3komma3volt/ssx32/README.md

# ssx32
Open source servo controller
using a PIC18F46K20

software by Michael Bradley http://www.mculabs.com/projects/ssx32.html

hardware by berndp using Eagle 7.0 Freeware
