3komma3volt/ssx32/Hardware/ssx32.brd

## EAGLE design Hardware/ssx32.brd (2016-06-15)

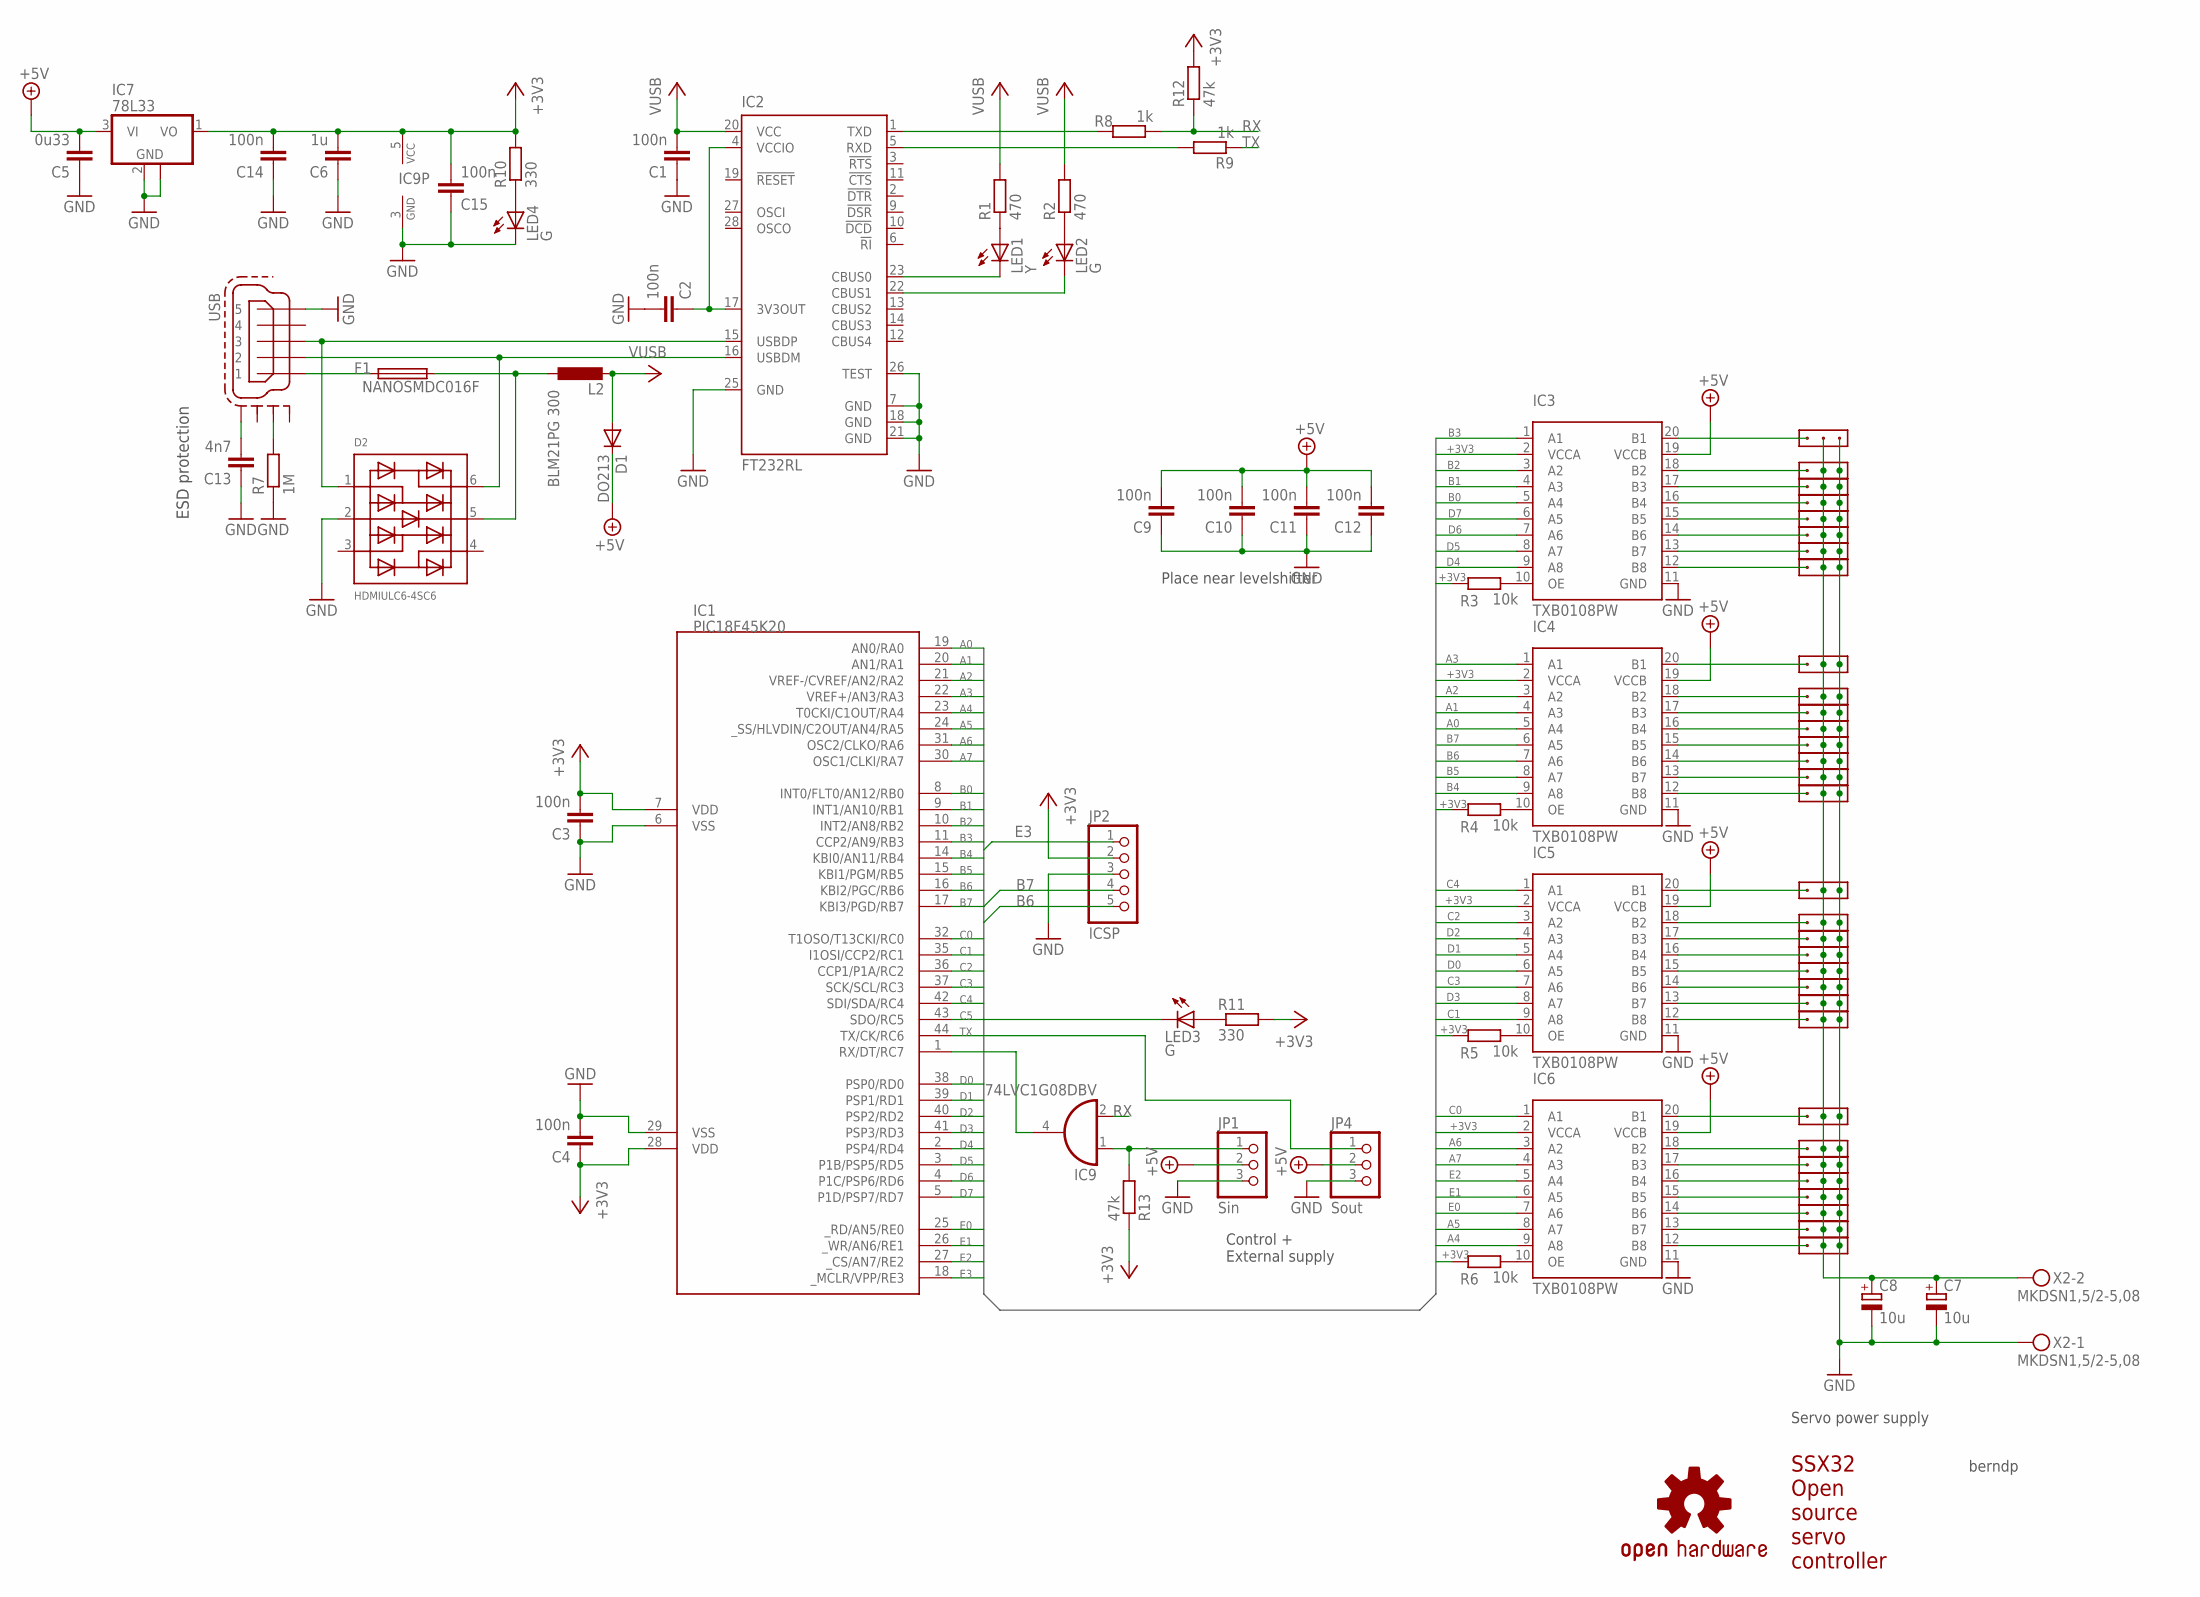
[picture p1: schematic ssx32.sch]

Parts:
C1, C2, C3, C4, C9, C10, C11, C12, C14, C15: 100n; C0603
C5: 0u33; C0805
C6: 1u; C0603
C7, C8: 10u; 153CLV-0505
C13: 4n7; C0603
D1: DO213; MINIMELF
D2: HDMIULC6-4SC6; SOT23-5
F1: NANOSMDC016F
IC1: PIC18F45K20; PIC18FXX20_TQFP44
IC2: FT232RL; SSOP28
IC3, IC4, IC5, IC6: TXB0108PW; PW_R-PDSO-G20
IC7: 78L33; SOT89
IC9: 74LVC1G08DBV; SOT23-5
JP1: Sin; 1X03
JP2: ICSP; 1X05
JP4: Sout; 1X03
L2: BLM21PG 300; R0805
LED1: Y; CHIPLED_0603
LED2, LED3, LED4: G; CHIPLED_0603
R1, R2: 470; R0603
R3, R4, R5, R6: 10k; R0603
R7: 1M; R0603
R8, R9: 1k; R0603
R10, R11: 330; R0603
R12, R13: 47k; R0603
U$2: OSHW-LOGOM; OSHW-LOGO-M
X1: 8; 1X3
X2: MKDSN1,5/2-5,08
X3: 17; 1X3
X4: 7; 1X3
X5: 6; 1X3
X6: 5; 1X3
X7: 4; 1X3
X8: 3; 1X3
X9: 2; 1X3
X10: 1; 1X3
X11: 19; 1X3
X12: 16; 1X3
X13: 15; 1X3
X14: 14; 1X3
X15: 13; 1X3
X16: 12; 1X3
X17: 11; 1X3
X18: 10; 1X3
X19: 9; 1X3
X20: 20; 1X3
X21: 21; 1X3
X22: 22; 1X3
X23: 23; 1X3
X24: 24; 1X3
X25: 25; 1X3
X26: 26; 1X3
X27: 27; 1X3
X28: 28; 1X3
X29: 29; 1X3
X30: 30; 1X3
X31: 31; 1X3
X32: 32; 1X3
X34: 18; 1X3
X35: USB; 32005-301

Connections:
+3V3: C3.2, C4.1, C6.2, C14.2, C15.2, IC1.7 (VDD), IC1.28 (VDD), IC3.2 (VCCA), IC4.2 (VCCA), IC5.2 (VCCA), IC6.2 (VCCA), IC7.1 (VO), IC9.5 (VCC), JP2.2, R3.1, R4.1, R5.1, R6.1, R10.2, R11.2, R12.2, R13.1
+5V: C1.2, D1.A, IC2.20 (VCC), L2.2, R1.2, R2.2
+UB: C5.2, C9.2, C10.2, C11.2, C12.2, D1.C, IC3.19 (VCCB), IC4.19 (VCCB), IC5.19 (VCCB), IC6.19 (VCCB), IC7.3 (VI), JP1.2, JP4.2
A0: IC1.19 (AN0/RA0), IC4.5 (A4)
A1: IC1.20 (AN1/RA1), IC4.4 (A3)
A2: IC1.21 (VREF-/CVREF/AN2/RA2), IC4.3 (A2)
A3: IC1.22 (VREF+/AN3/RA3), IC4.1 (A1)
A4: IC1.23 (T0CKI/C1OUT/RA4), IC6.9 (A8)
A5: IC1.24 (_SS/HLVDIN/C2OUT/AN4/RA5), IC6.8 (A7)
A6: IC1.31 (OSC2/CLKO/RA6), IC6.3 (A2)
A7: IC1.30 (OSC1/CLKI/RA7), IC6.4 (A3)
B0: IC1.8 (INT0/FLT0/AN12/RB0), IC3.5 (A4)
B1: IC1.9 (INT1/AN10/RB1), IC3.4 (A3)
B2: IC1.10 (INT2/AN8/RB2), IC3.3 (A2)
B3: IC1.11 (CCP2/AN9/RB3), IC3.1 (A1)
B4: IC1.14 (KBI0/AN11/RB4), IC4.9 (A8)
B5: IC1.15 (KBI1/PGM/RB5), IC4.8 (A7)
B6: IC1.16 (KBI2/PGC/RB6), IC4.7 (A6), JP2.5
B7: IC1.17 (KBI3/PGD/RB7), IC4.6 (A5), JP2.4
C0: IC1.32 (T1OSO/T13CKI/RC0), IC6.1 (A1)
C1: IC1.35 (I1OSI/CCP2/RC1), IC5.9 (A8)
C2: IC1.36 (CCP1/P1A/RC2), IC5.8 (A7)
C3: IC1.37 (SCK/SCL/RC3), IC5.7 (A6)
C4: IC1.42 (SDI/SDA/RC4), IC5.1 (A1)
C5: IC1.43 (SDO/RC5), LED3.C
D0: IC1.38 (PSP0/RD0), IC5.6 (A5)
D1: IC1.39 (PSP1/RD1), IC5.5 (A4)
D2: IC1.40 (PSP2/RD2), IC5.4 (A3)
D3: IC1.41 (PSP3/RD3), IC5.3 (A2)
D4: IC1.2 (PSP4/RD4), IC3.9 (A8)
D5: IC1.3 (P1B/PSP5/RD5), IC3.8 (A7)
D6: IC1.4 (P1C/PSP6/RD6), IC3.7 (A6)
D7: IC1.5 (P1D/PSP7/RD7), IC3.6 (A5)
E0: IC1.25 (_RD/AN5/RE0), IC6.7 (A6)
E1: IC1.26 (_WR/AN6/RE1), IC6.6 (A5)
E2: IC1.27 (_CS/AN7/RE2), IC6.5 (A4)
E3: IC1.18 (_MCLR/VPP/RE3), JP2.1
GND: C1.1, C2.2, C3.1, C4.2, C5.1, C6.1, C7.-, C8.-, C9.1, C10.1, C11.1, C12.1, C13.1, C14.1, C15.1, D2.2, IC1.6 (VSS), IC1.29 (VSS), IC2.7 (GND), IC2.18 (GND), IC2.21 (GND), IC2.25 (GND), IC2.26 (TEST), IC3.11 (GND), IC4.11 (GND), IC5.11 (GND), IC6.11 (GND), IC7.2 (GND), IC7.2@1 (GND), IC9.3 (GND), JP1.3, JP2.3, JP4.3, LED4.C, R7.1, X1.P$3, X2.1, X3.P$3, X4.P$3, X5.P$3, X6.P$3, X7.P$3, X8.P$3, X9.P$3, X10.P$3, X11.P$3, X12.P$3, X13.P$3, X14.P$3, X15.P$3, X16.P$3, X17.P$3, X18.P$3, X19.P$3, X20.P$3, X21.P$3, X22.P$3, X23.P$3, X24.P$3, X25.P$3, X26.P$3, X27.P$3, X28.P$3, X29.P$3, X30.P$3, X31.P$3, X32.P$3, X34.P$3, X35.5
unnamed: D2.6, IC2.16 (USBDM), X35.2
unnamed: F1.1, X35.1
unnamed: IC2.23 (CBUS0), LED1.C
unnamed: IC2.22 (CBUS1), LED2.C
unnamed: LED1.A, R1.1
unnamed: LED2.A, R2.1
unnamed: IC3.20 (B1), X1.P$1
unnamed: IC3.10 (OE), R3.2
unnamed: IC4.10 (OE), R4.2
unnamed: IC5.10 (OE), R5.2
unnamed: IC6.10 (OE), R6.2
unnamed: IC4.18 (B2), X13.P$1
unnamed: IC3.18 (B2), X4.P$1
unnamed: IC3.17 (B3), X5.P$1
unnamed: IC3.16 (B4), X6.P$1
unnamed: IC3.15 (B5), X7.P$1
unnamed: IC3.14 (B6), X8.P$1
unnamed: IC3.13 (B7), X9.P$1
unnamed: IC3.12 (B8), X10.P$1
unnamed: IC5.17 (B3), X11.P$1
unnamed: IC4.17 (B3), X14.P$1
unnamed: IC4.16 (B4), X15.P$1
unnamed: IC4.15 (B5), X16.P$1
unnamed: IC4.14 (B6), X17.P$1
unnamed: IC4.13 (B7), X18.P$1
unnamed: IC4.12 (B8), X19.P$1
unnamed: IC5.16 (B4), X20.P$1
unnamed: IC5.15 (B5), X21.P$1
unnamed: IC5.14 (B6), X22.P$1
unnamed: IC5.13 (B7), X23.P$1
unnamed: IC5.12 (B8), X24.P$1
unnamed: IC5.20 (B1), X3.P$1
unnamed: IC4.20 (B1), X12.P$1
unnamed: IC6.16 (B4), X28.P$1
unnamed: IC6.15 (B5), X29.P$1
unnamed: IC6.14 (B6), X30.P$1
unnamed: IC6.13 (B7), X31.P$1
unnamed: IC6.12 (B8), X32.P$1
unnamed: IC6.18 (B2), X26.P$1
unnamed: IC6.17 (B3), X27.P$1
unnamed: IC6.20 (B1), X25.P$1
unnamed: IC5.18 (B2), X34.P$1
unnamed: LED3.A, R11.1
unnamed: D2.1, IC2.15 (USBDP), X35.3
unnamed: IC1.1 (RX/DT/RC7), IC9.4 (O)
unnamed: R7.2, X35.M2 (S2)
unnamed: C13.2, X35.M4 (S4)
unnamed: D2.5, F1.2, L2.1
unnamed: IC2.5 (RXD), R9.2
unnamed: IC2.1 (TXD), R8.2
unnamed: IC9.1 (I0), JP1.1, R13.2
unnamed: LED4.A, R10.1
RX: IC9.2 (I1), R8.1, R12.1
TX: IC1.44 (TX/CK/RC6), JP4.1, R9.1
VPORT: C2.1, IC2.4 (VCCIO), IC2.17 (3V3OUT)
VSERVO: C7.+, C8.+, X1.P$2, X2.2, X3.P$2, X4.P$2, X5.P$2, X6.P$2, X7.P$2, X8.P$2, X9.P$2, X10.P$2, X11.P$2, X12.P$2, X13.P$2, X14.P$2, X15.P$2, X16.P$2, X17.P$2, X18.P$2, X19.P$2, X20.P$2, X21.P$2, X22.P$2, X23.P$2, X24.P$2, X25.P$2, X26.P$2, X27.P$2, X28.P$2, X29.P$2, X30.P$2, X31.P$2, X32.P$2, X34.P$2

Notes on the sheet:
Place near levelshifter
SSX32 Open source servo controller
ESD protection
Servo power supply
berndp
Control + External supply

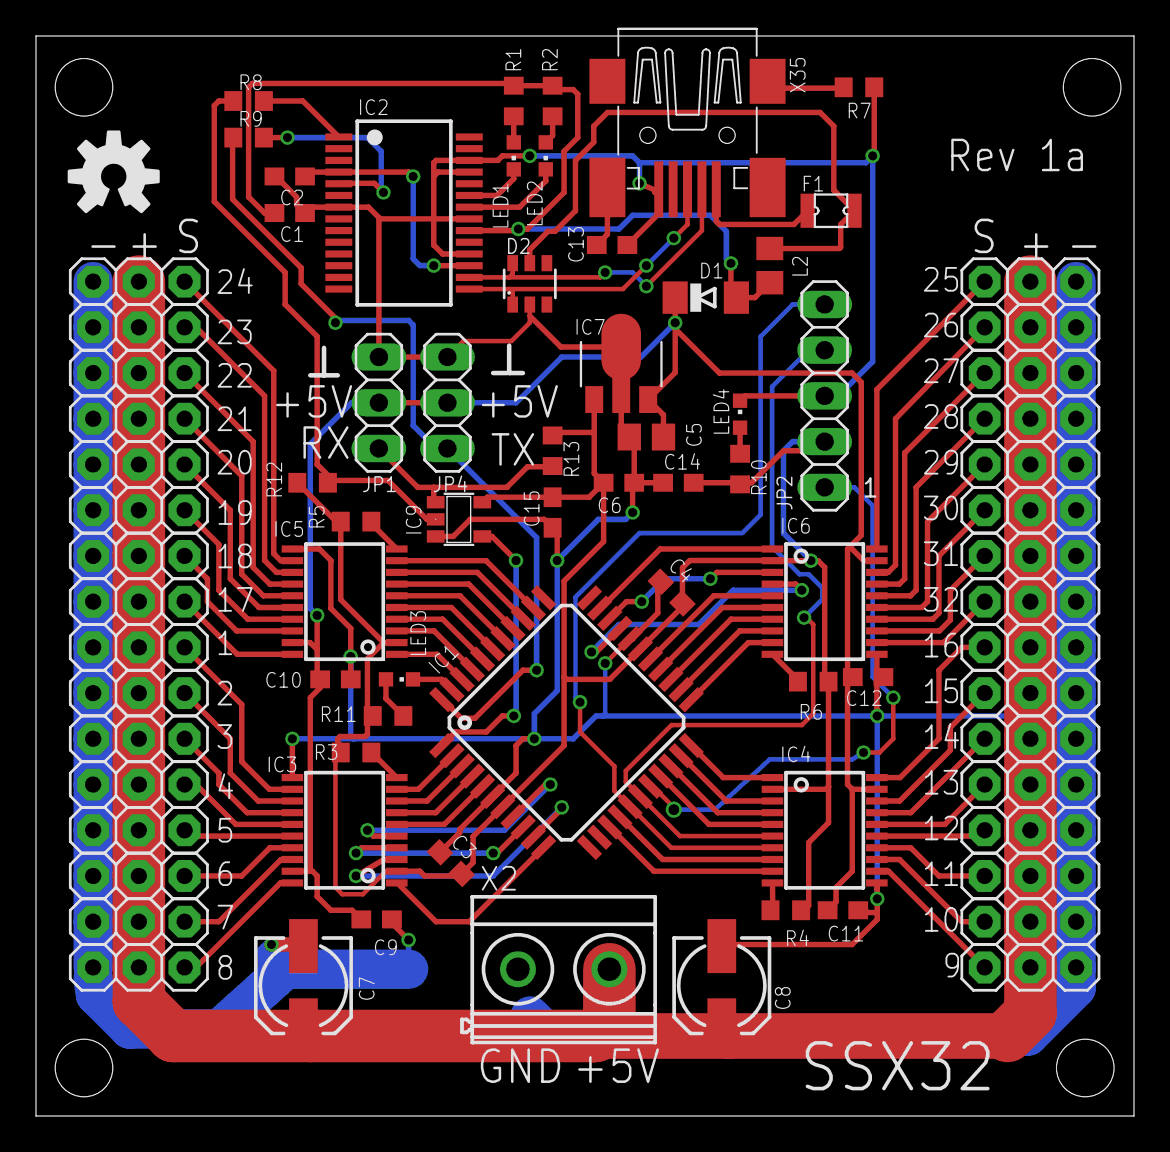
[picture p2: board ssx32.brd from above]

Board: 2 copper layers, 61.0 x 60.0 mm, 82 parts (0 on the bottom side), 94 nets.
