3komma3volt/ssx32/Firmware/pic-ssx16.h

/*
          file: pic-ssx16.h
       project: SSX32 
   description: pic device info for ssx16 model

   Changelog:
	  09/17/11 This file moved from main.h
      01/15/11 This file created


*/
#include <18F26K20.h>
#device PASS_STRINGS=IN_RAM
#device adc=8

#FUSES NOWDT                    //No Watch Dog Timer
#FUSES WDT128                   //Watch Dog Timer uses 1:128 Postscale
#FUSES INTRC_IO                 //Internal RC Osc, no CLKOUT
#FUSES NOPROTECT                //Code not protected from reading
#FUSES NOBROWNOUT               //No brownout reset
//#FUSES BORV18
#FUSES NOPUT                    //No Power Up Timer
#FUSES NOCPD                    //No EE protection
#FUSES STVREN                   //Stack full/underflow will cause reset
#FUSES NODEBUG                  //No Debug mode for ICD
#FUSES NOLVP                    //No low voltage prgming, B3(PIC16) or B5(PIC18) used for I/O
#FUSES NOWRT                    //Program memory not write protected
#FUSES NOWRTD                   //Data EEPROM not write protected
#FUSES IESO                     //Internal External Switch Over mode enabled
#FUSES FCMEN                    //Fail-safe clock monitor enabled
#FUSES NOPBADEN                 //PORTB pins are configured as digital I/O on RESET
#FUSES NOWRTC                   //configuration not registers write protected
#FUSES NOWRTB                   //Boot block not write protected
#FUSES NOEBTR                   //Memory not protected from table reads
#FUSES NOEBTRB                  //Boot block not protected from table reads
#FUSES NOCPB                    //No Boot Block code protection
#FUSES LPT1OSC                  //Timer1 configured for low-power operation
#FUSES NOMCLR                   //Master Clear pin used for I/O
#FUSES NOXINST                  //Extended set extension and Indexed Addressing mode disabled (Legacy mode)
#FUSES NODELAYINTOSC         
#use delay(clock=64000000)
