3komma3volt/ssx32/(commit log)

2016-03-26 Board commit
    Inital commit of PCB
    using Eagle 7
    [ssx32.brd, ssx32.sch]
2016-03-27 Changed Board
    Added polyfuse
    Changed component values
    Replaced some components for easier PnP
    [ssx32.brd, ssx32.sch]
2016-03-28 Error correction
    Changed missconnected PIC power supply
    Added protection for serial signals
    Changed inductors to ferrite beads
    Removed voltage select jumper
    [ssx32.brd, ssx32.sch]
2016-04-13 Added Plane
    Added groundplane
    Increased servo VCC trace width
    [ssx32.brd, ssx32.sch]
2016-05-11 Fixed ICSP interface
    Fixed missconnected ICSP interface
    [ssx32.brd, ssx32.sch]
2016-05-12 Added software, minor board changes
    Added software
    Added resistor for not mounted ftdi chip
    [ssx32.brd, ssx32.sch]
2016-06-14 Fixed schematic errors
    Added AND gate for the serial communication
    Repositioned ferrite bead
    [ssx32.sch]
2016-06-15 Revert "Fixed schematic errors"
    This reverts commit bc55cbd2c08a143a3db725eeb6975bb6eadbf5e7.
    [ssx32.sch]
2016-06-15 Revert "Revert "Fixed schematic errors""
    This reverts commit 02a030f20bdd3dfa1fc93a39d84e363c4da10222.
    [ssx32.sch]
2016-06-15 Revert "Added software, minor board changes"
    This reverts commit cd959f70c37cd81d74ff6deb02d888d0a529ccba.
    [ssx32.brd, ssx32.sch]
2016-06-15 Fixed issues
    Replaced OR with AND gate with pullups
    Removed unnecessary ferrite bead
    [ssx32.brd, ssx32.sch]
2016-07-07 Added test software
    Added a C# application for quick tests of the servo controller
    [ssx32.sch]
